apertus-open-source-cinema/alpha-hardware/SFE-PCB/ExpressPCB - discontinued/space-on-zedboard-01.jpg

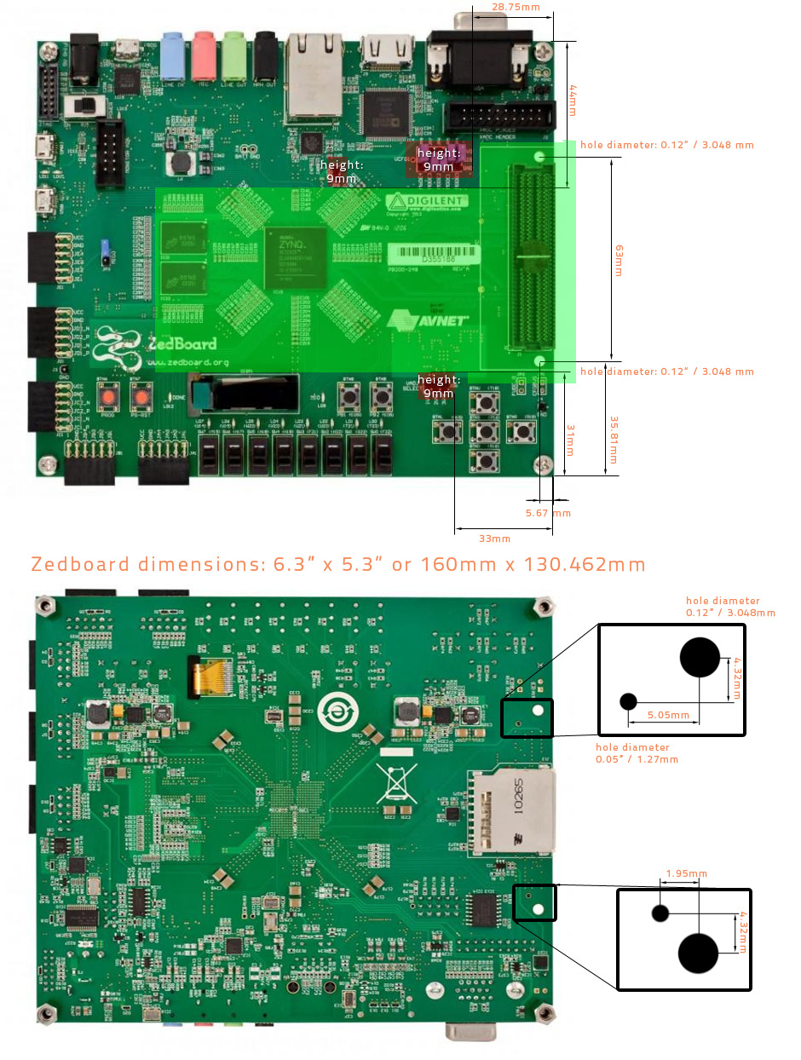
SFE-PCB/ExpressPCB - discontinued/space-on-zedboard-01.jpg
