apertus-open-source-cinema/alpha-hardware/README.md

alpha-hardware
==============

Axiom Alpha prototype hardware source files (electronic schematics, documentation, PCB layouts, etc.)
