apertus-open-source-cinema/alpha-hardware/Nikon-F-Mount/apertus-axiom-alpha-lens-mount01.jpg

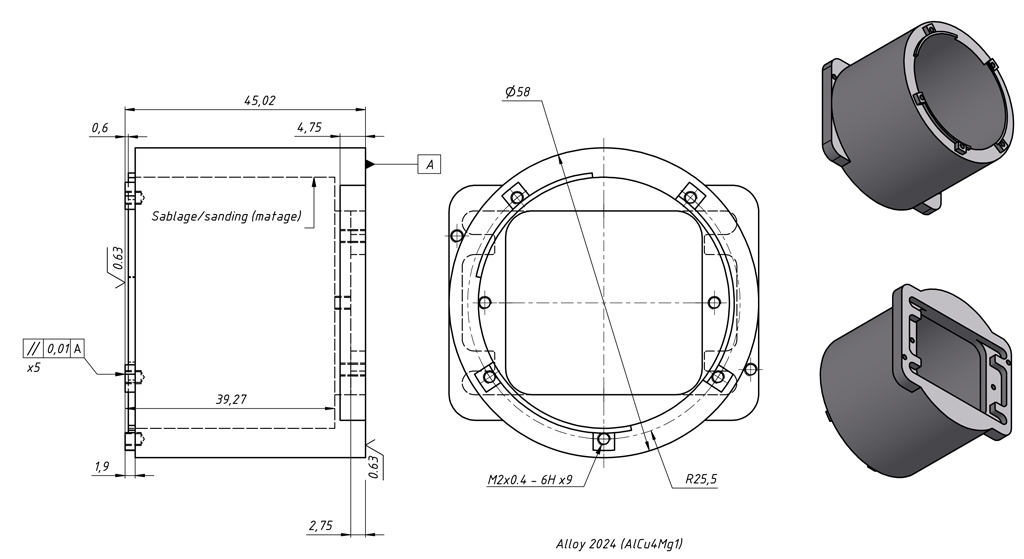
Nikon-F-Mount/apertus-axiom-alpha-lens-mount01.jpg
