apertus-open-source-cinema/alpha-hardware/Nikon-F-Mount/apertus-axiom-alpha-lens-mount03.jpg

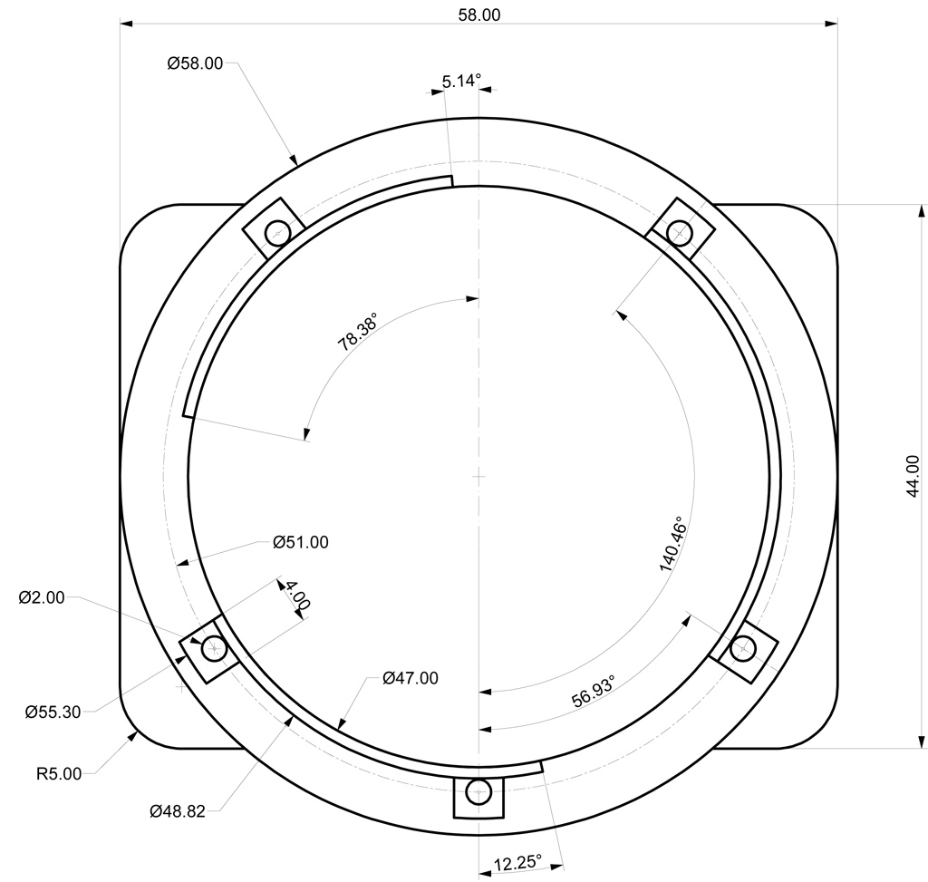
Nikon-F-Mount/apertus-axiom-alpha-lens-mount03.jpg
