apertus-open-source-cinema/alpha-hardware/Paddle/paddle_board.png

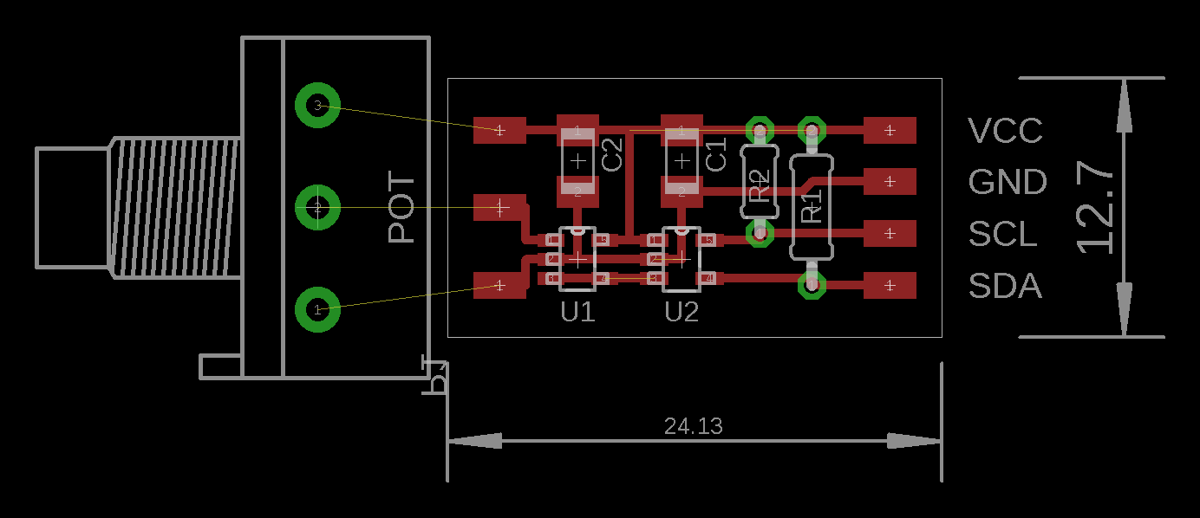
Paddle/paddle_board.png
