apertus-open-source-cinema/alpha-hardware/SFE-PCB/ExpressPCB - discontinued/power-planes01.jpg

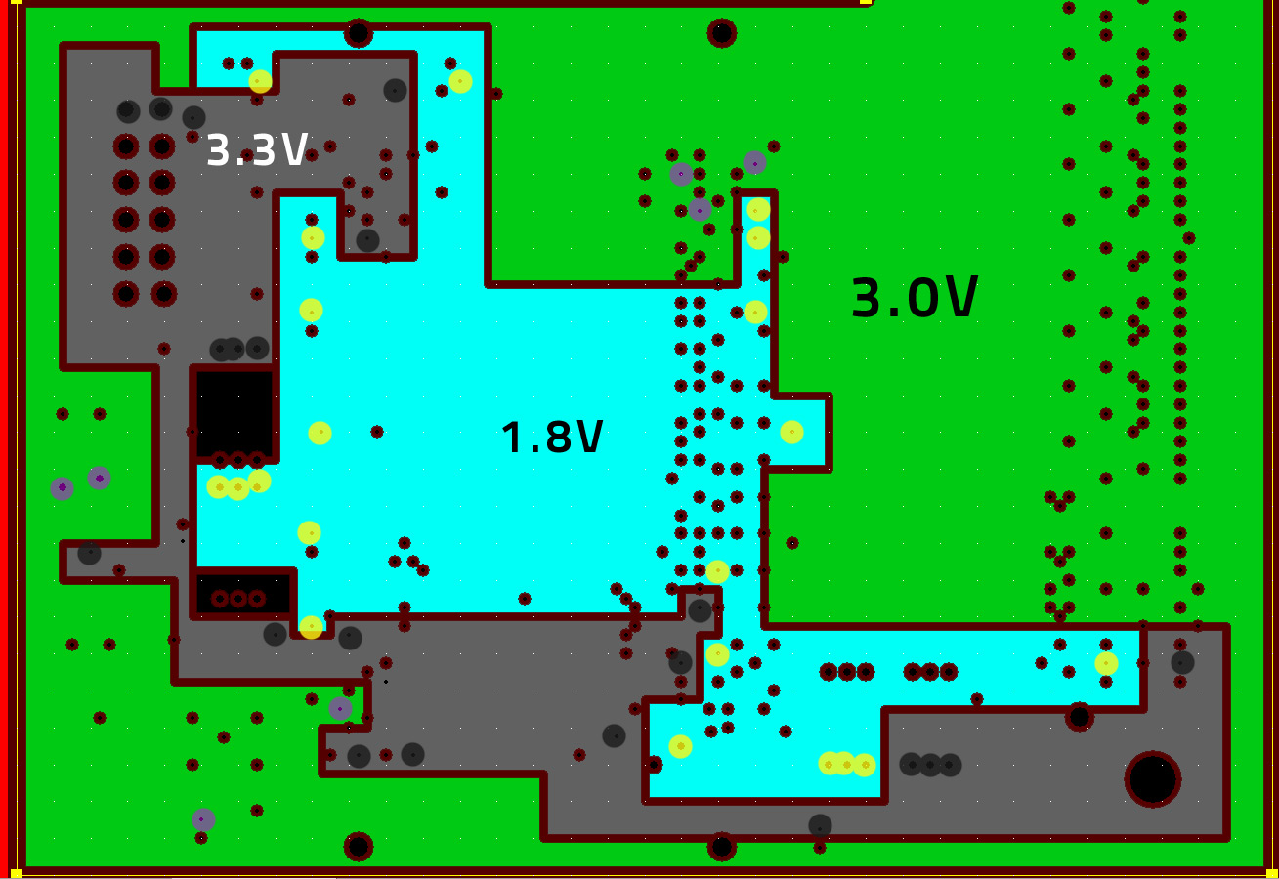
SFE-PCB/ExpressPCB - discontinued/power-planes01.jpg
