apertus-open-source-cinema/alpha-hardware/Nikon-F-Mount/F-mount to CMV12k-V04.stp

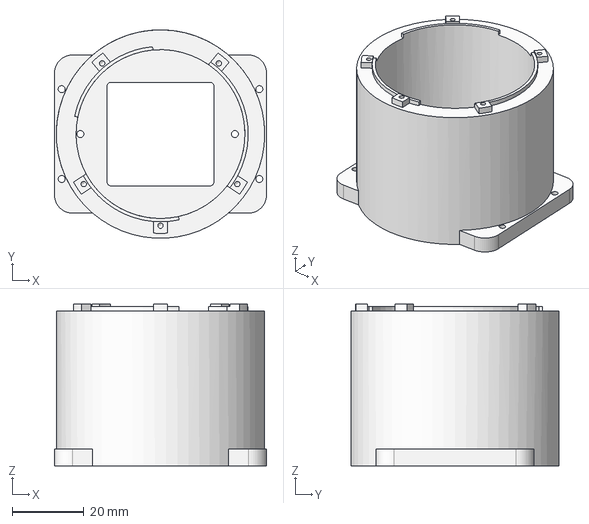
[picture p7: CAD file, 2014-06-10]
Nikon-F-Mount/F-mount to CMV12k-V04.stp
59.0 x 58.0 x 45.0 mm
