apertus-open-source-cinema/alpha-hardware/PMOD-Debug-LedMatrix/Readme.txt

About
---------
A very small PCB sporting 64 LEDs that connect to most FPGA development boards (like the Zedboard) with a PMOD interface
This PCB provides an easy way to debug FPGA logic with just 8 digital lines and a 4-to-16 line decoder with minimal interface logic required in the FPGA side (PL).

Filetypes
---------
Eagle Schematic and Board Design (XML)

License
---------
CERN Open Hardware License 1.1
http://www.ohwr.org/attachments/735/CERNOHLv1_1.txt

Author
---------
Herbert Poetzl - herbert@13thfloor.at
