apertus-open-source-cinema/alpha-hardware/Paddle/paddle_schematic.pdf

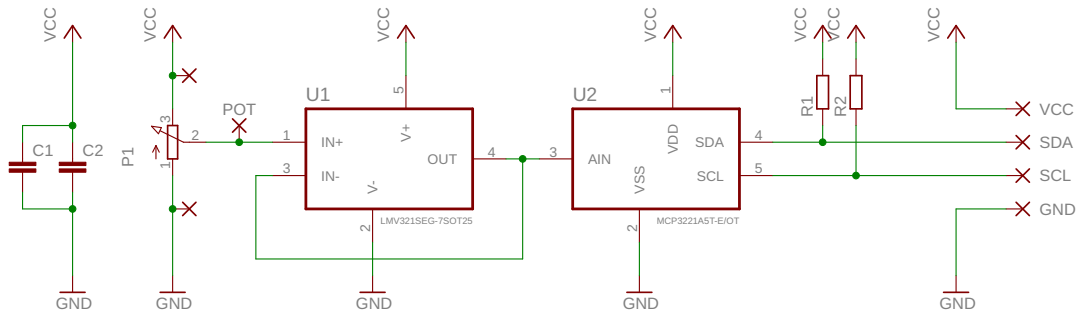
[picture p8: page 1]

Paddle Controller
Amplifier and IIC Digitizer
12bit Resolution, IIC Terminated
Copyright (C) 2014 H.Poetzl
Licensed under CERN OHL v.1.1
