apertus-open-source-cinema/alpha-hardware/Nikon-F-Mount/F-mount to CMV12k-V04.pdf

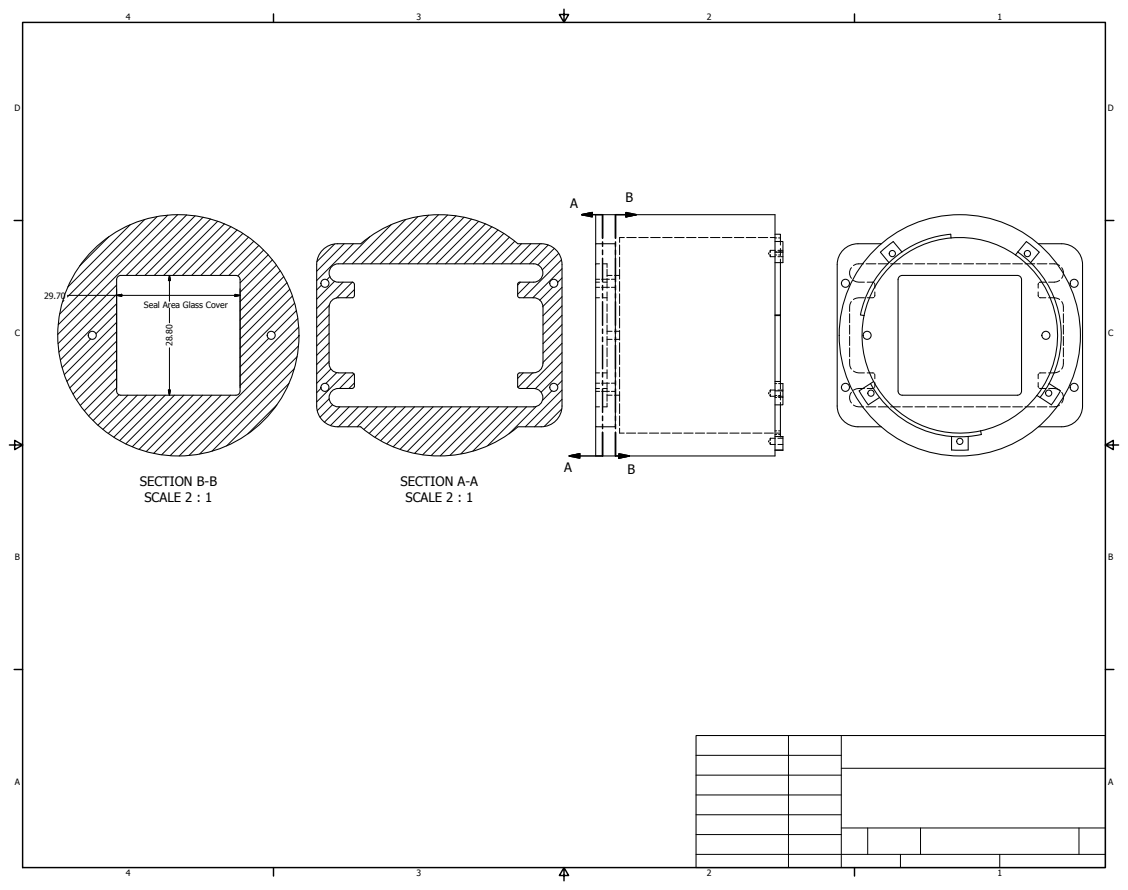
[picture p9: page 1]
SECTION A-A SCALE 2 : 1; SECTION B-B SCALE 2 : 1

Seal Area Glass Cover
