apertus-open-source-cinema/alpha-hardware/(list of files, drawings)

Other design files:
SFE-PCB/archived/ExpressPCB - discontinued/cmv12000 adapter V002.pcb
SFE-PCB/archived/ExpressPCB - discontinued/cmv12000 adapter V003.pcb
SFE-PCB/archived/ExpressPCB - discontinued/cmv12000 adapter V004.pcb
SFE-PCB/archived/ExpressPCB - discontinued/cmv12000 adapter V005.pcb
SFE-PCB/archived/ExpressPCB - discontinued/cmv12000 adapter V006.pcb
SFE-PCB/archived/ExpressPCB - discontinued/cmv12000 adapter V007.pcb
SFE-PCB/archived/ExpressPCB - discontinued/cmv12000 adapter V008.pcb
SFE-PCB/archived/ExpressPCB - discontinued/cmv12000 adapter V009.pcb
SFE-PCB/archived/ExpressPCB - discontinued/cmv12000 adapter.pcb
SFE-PCB/ExpressPCB - discontinued/cmv12000 adapter V002.pcb
SFE-PCB/ExpressPCB - discontinued/cmv12000 adapter V003.pcb
SFE-PCB/ExpressPCB - discontinued/cmv12000 adapter V004.pcb
SFE-PCB/ExpressPCB - discontinued/cmv12000 adapter V005.pcb
SFE-PCB/ExpressPCB - discontinued/cmv12000 adapter V006.pcb
SFE-PCB/ExpressPCB - discontinued/cmv12000 adapter V007.pcb
SFE-PCB/ExpressPCB - discontinued/cmv12000 adapter V008.pcb
SFE-PCB/ExpressPCB - discontinued/cmv12000 adapter V009.pcb
SFE-PCB/ExpressPCB - discontinued/cmv12000 adapter.pcb
