apertus-open-source-cinema/alpha-hardware/Paddle/paddle.brd

## EAGLE design Paddle/paddle.brd (2014-04-01)

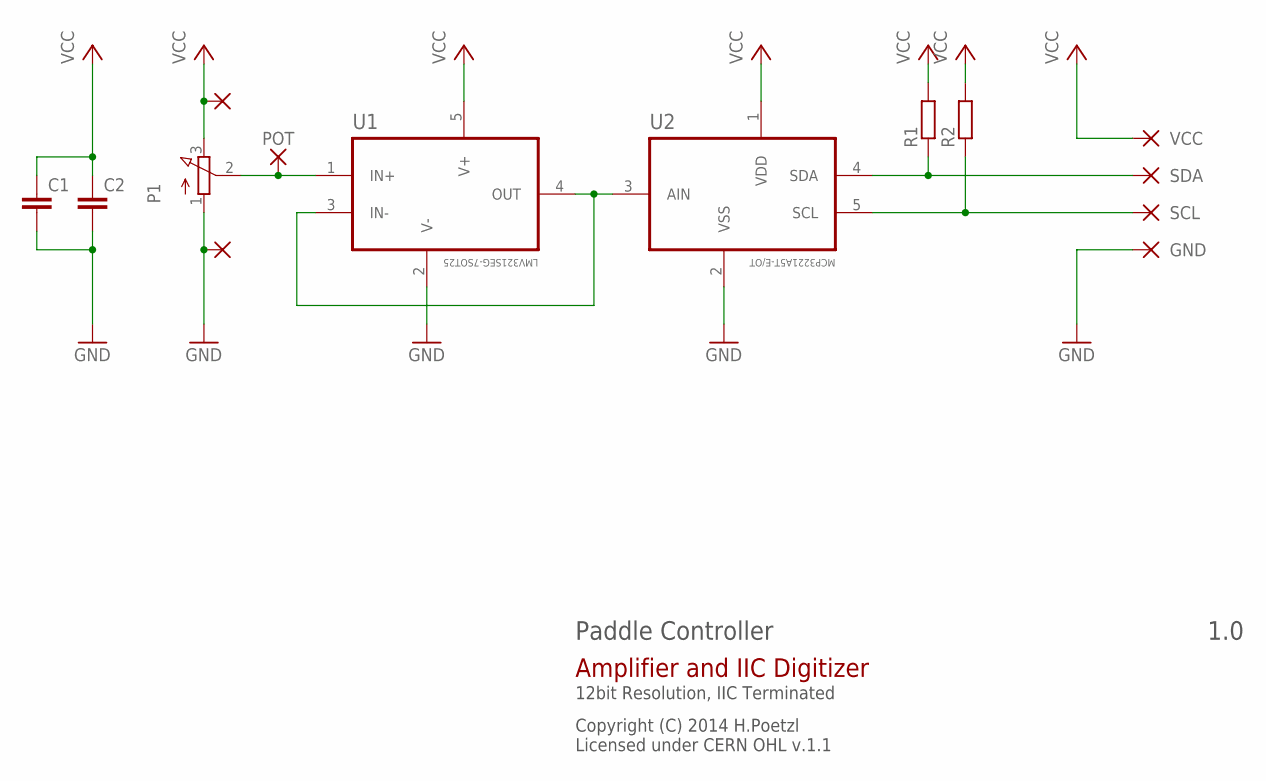
[picture p10: schematic paddle.sch]

Parts:
C1, C2: C-EUC1206K; C1206K
GND: SMD2; SMD1,27-2,54
P1: 3RP/1610N
POT: SMD2; SMD1,27-2,54
R1: R-EU_0204/7; 0204/7
R2: R-EU_0204/5; 0204/5
SCL: SMD2; SMD1,27-2,54
SDA: SMD2; SMD1,27-2,54
U1: LMV321SEG-7SOT25; SOT95P280X145-5N
U2: MCP3221A5T-E/OT; SOT95P270X145-5N
VCC, VCC1, VCC2: SMD2; SMD1,27-2,54

Connections:
GND: C1.2, C2.2, GND.1, P1.1 (A), U1.2 (V-), U2.2 (VSS), VCC2.1
unnamed: U1.3 (IN-), U1.4 (OUT), U2.3 (AIN)
POT: P1.2 (S), POT.1, U1.1 (IN+)
SCL: R2.1, SCL.1, U2.5 (SCL)
SDA: R1.1, SDA.1, U2.4 (SDA)
VCC: C1.1, C2.1, P1.3 (E), R1.2, R2.2, U1.5 (V+), U2.1 (VDD), VCC.1, VCC1.1

Notes on the sheet:
Paddle Controller
Copyright (C) 2014 H.Poetzl Licensed under CERN OHL v.1.1
Amplifier and IIC Digitizer
12bit Resolution, IIC Terminated

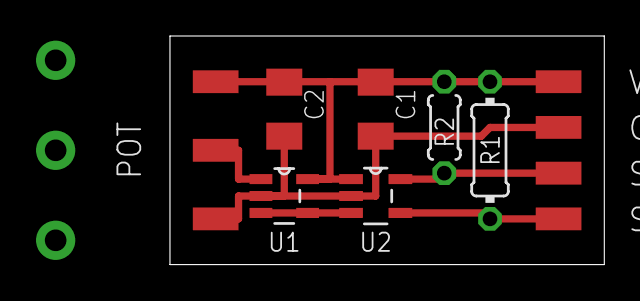
[picture p11: board paddle.brd from above]

Board: 2 copper layers, 24.1 x 12.7 mm, 14 parts (1 on the bottom side), 6 nets.
