apertus-open-source-cinema/alpha-hardware/SFE-PCB/cmv12k-adapter-v1.1/cmv12k-adapter-v1.1.brd

## EAGLE design SFE-PCB/cmv12k-adapter-v1.1/cmv12k-adapter-v1.1.brd (2013-10-28, an earlier design)

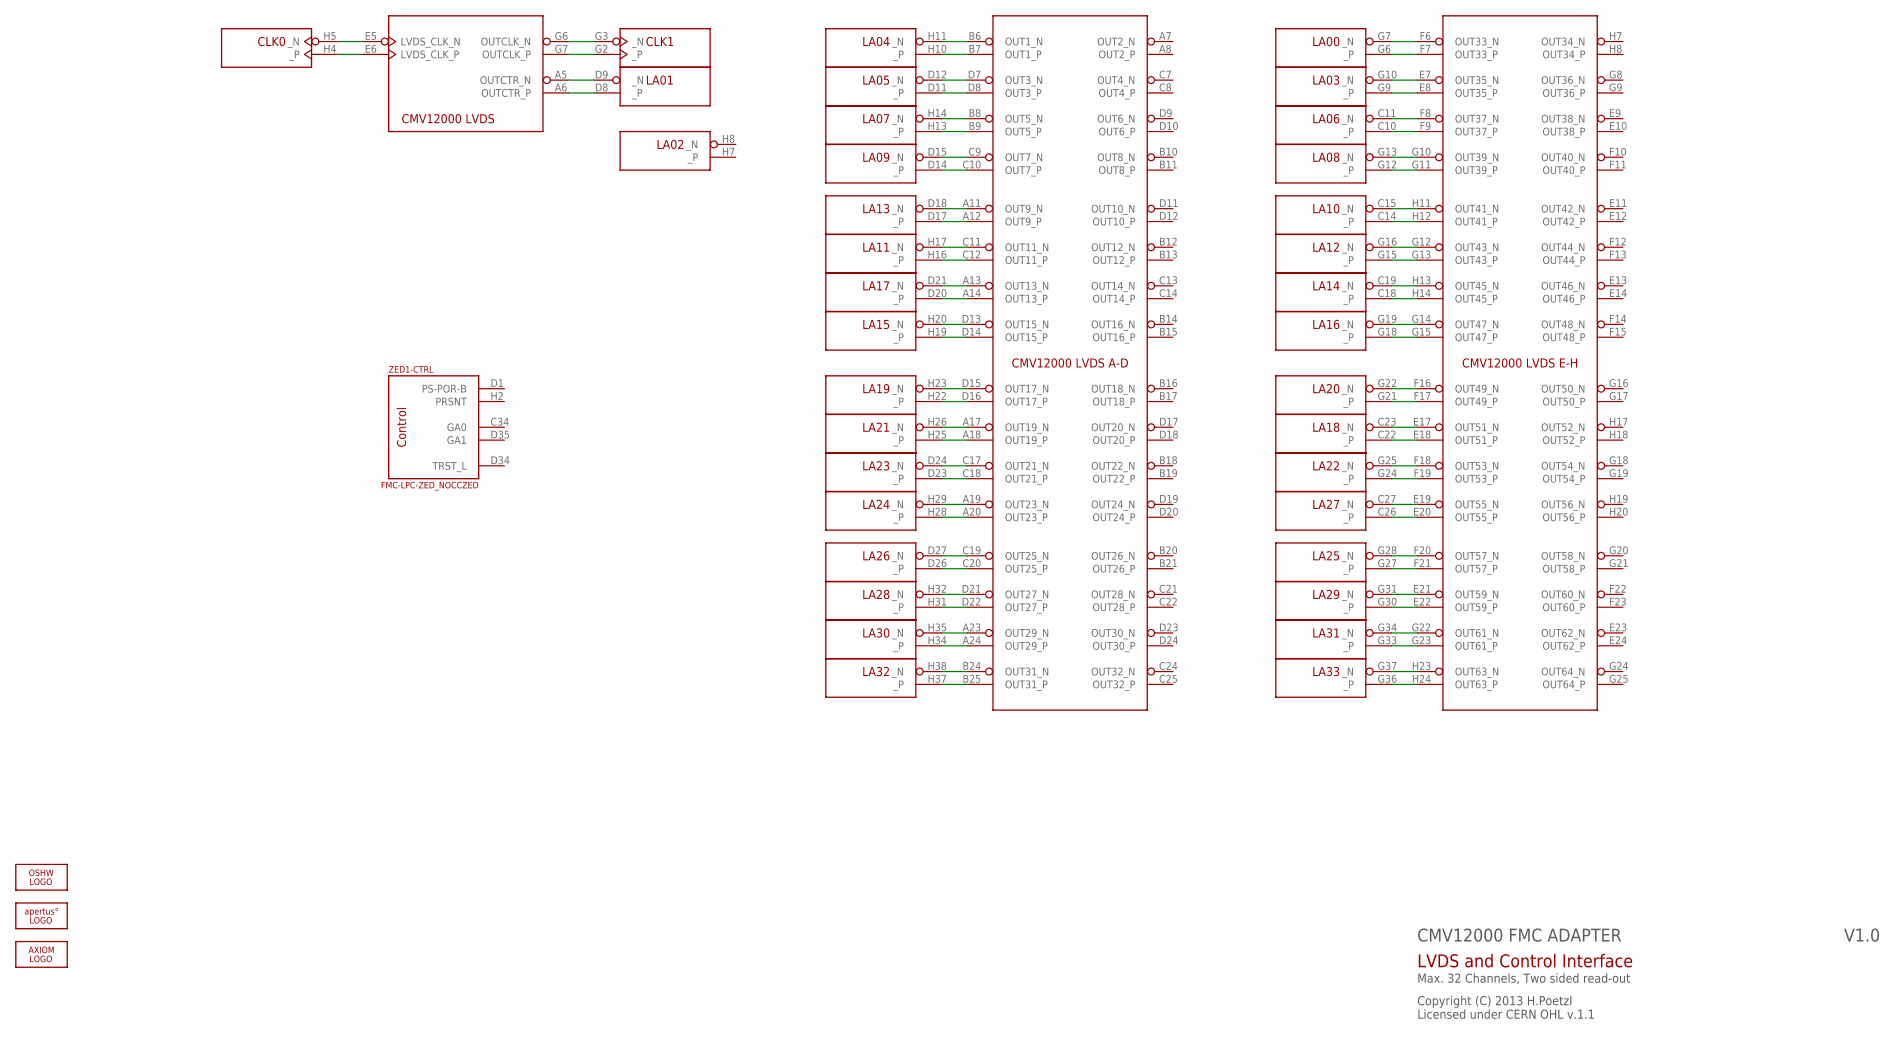
[picture p12: schematic cmv12k-adapter-v1.1.sch, sheet 1]

Parts:
LOGO1: OSHW_LOGO_FILLX0100-NT; OSHW_FILLX100_NOTEXT
U$1: CMV12000ANDON+LM; 10-30-07-237-400T4+LM
U$5: APERTUS_LOGO334X100; APERTUS_LOGO_334X100
U$13: AXIOM_LOGO525X80; AXIOM_LOGO_525X80
ZED1: FMC-LPC-ZED_NOCCZED; ASP-134604-01-ZED

Connections:
unnamed: U$1.B6 (OUT1_N), ZED1.H11 (_N)
unnamed: U$1.B7 (OUT1_P), ZED1.H10 (_P)
unnamed: U$1.D7 (OUT3_N), ZED1.D12 (_N)
unnamed: U$1.D8 (OUT3_P), ZED1.D11 (_P)
unnamed: U$1.B8 (OUT5_N), ZED1.H14 (_N)
unnamed: U$1.C9 (OUT7_N), ZED1.D15 (_N)
unnamed: U$1.C10 (OUT7_P), ZED1.D14 (_P)
unnamed: U$1.G10 (OUT39_N), ZED1.G13 (_N)
unnamed: U$1.A11 (OUT9_N), ZED1.D18 (_N)
unnamed: U$1.A12 (OUT9_P), ZED1.D17 (_P)
unnamed: U$1.C11 (OUT11_N), ZED1.H17 (_N)
unnamed: U$1.C12 (OUT11_P), ZED1.H16 (_P)
unnamed: U$1.A13 (OUT13_N), ZED1.D21 (_N)
unnamed: U$1.A14 (OUT13_P), ZED1.D20 (_P)
unnamed: U$1.D13 (OUT15_N), ZED1.H20 (_N)
unnamed: U$1.D14 (OUT15_P), ZED1.H19 (_P)
unnamed: U$1.F16 (OUT49_N), ZED1.G22 (_N)
unnamed: U$1.F17 (OUT49_P), ZED1.G21 (_P)
unnamed: U$1.A17 (OUT19_N), ZED1.H26 (_N)
unnamed: U$1.A18 (OUT19_P), ZED1.H25 (_P)
unnamed: U$1.C17 (OUT21_N), ZED1.D24 (_N)
unnamed: U$1.C18 (OUT21_P), ZED1.D23 (_P)
unnamed: U$1.A19 (OUT23_N), ZED1.H29 (_N)
unnamed: U$1.A20 (OUT23_P), ZED1.H28 (_P)
unnamed: U$1.C19 (OUT25_N), ZED1.D27 (_N)
unnamed: U$1.C20 (OUT25_P), ZED1.D26 (_P)
unnamed: U$1.D21 (OUT27_N), ZED1.H32 (_N)
unnamed: U$1.D22 (OUT27_P), ZED1.H31 (_P)
unnamed: U$1.A23 (OUT29_N), ZED1.H35 (_N)
unnamed: U$1.A24 (OUT29_P), ZED1.H34 (_P)
unnamed: U$1.B24 (OUT31_N), ZED1.H38 (_N)
unnamed: U$1.B25 (OUT31_P), ZED1.H37 (_P)
unnamed: U$1.D15 (OUT17_N), ZED1.H23 (_N)
unnamed: U$1.D16 (OUT17_P), ZED1.H22 (_P)
unnamed: U$1.G22 (OUT61_N), ZED1.G34 (_N)
unnamed: U$1.G23 (OUT61_P), ZED1.G33 (_P)
unnamed: U$1.E22 (OUT59_P), ZED1.G30 (_P)
unnamed: U$1.E21 (OUT59_N), ZED1.G31 (_N)
unnamed: U$1.F21 (OUT57_P), ZED1.G27 (_P)
unnamed: U$1.F20 (OUT57_N), ZED1.G28 (_N)
unnamed: U$1.E20 (OUT55_P), ZED1.C26 (_P)
unnamed: U$1.E19 (OUT55_N), ZED1.C27 (_N)
unnamed: U$1.F19 (OUT53_P), ZED1.G24 (_P)
unnamed: U$1.F18 (OUT53_N), ZED1.G25 (_N)
unnamed: U$1.E18 (OUT51_P), ZED1.C22 (_P)
unnamed: U$1.E17 (OUT51_N), ZED1.C23 (_N)
unnamed: U$1.H23 (OUT63_N), ZED1.G37 (_N)
unnamed: U$1.H24 (OUT63_P), ZED1.G36 (_P)
unnamed: U$1.G15 (OUT47_P), ZED1.G18 (_P)
unnamed: U$1.G14 (OUT47_N), ZED1.G19 (_N)
unnamed: U$1.H14 (OUT45_P), ZED1.C18 (_P)
unnamed: U$1.H13 (OUT45_N), ZED1.C19 (_N)
unnamed: U$1.G13 (OUT43_P), ZED1.G15 (_P)
unnamed: U$1.G12 (OUT43_N), ZED1.G16 (_N)
unnamed: U$1.H12 (OUT41_P), ZED1.C14 (_P)
unnamed: U$1.H11 (OUT41_N), ZED1.C15 (_N)
unnamed: U$1.G11 (OUT39_P), ZED1.G12 (_P)
unnamed: U$1.B9 (OUT5_P), ZED1.H13 (_P)
unnamed: U$1.F9 (OUT37_P), ZED1.C10 (_P)
unnamed: U$1.F8 (OUT37_N), ZED1.C11 (_N)
unnamed: U$1.E8 (OUT35_P), ZED1.G9 (_P)
unnamed: U$1.E7 (OUT35_N), ZED1.G10 (_N)
unnamed: U$1.F7 (OUT33_P), ZED1.G6 (_P)
unnamed: U$1.F6 (OUT33_N), ZED1.G7 (_N)
unnamed: U$1.E5 (LVDS_CLK_N), ZED1.H5 (_N)
unnamed: U$1.E6 (LVDS_CLK_P), ZED1.H4 (_P)
unnamed: U$1.G6 (OUTCLK_N), ZED1.G3 (_N)
unnamed: U$1.G7 (OUTCLK_P), ZED1.G2 (_P)
unnamed: U$1.A5 (OUTCTR_N), ZED1.D9 (_N)
unnamed: U$1.A6 (OUTCTR_P), ZED1.D8 (_P)

Notes on the sheet:
CMV12000 FMC ADAPTER
Copyright (C) 2013 H.Poetzl Licensed under CERN OHL v.1.1
LVDS and Control Interface
Max. 32 Channels, Two sided read-out

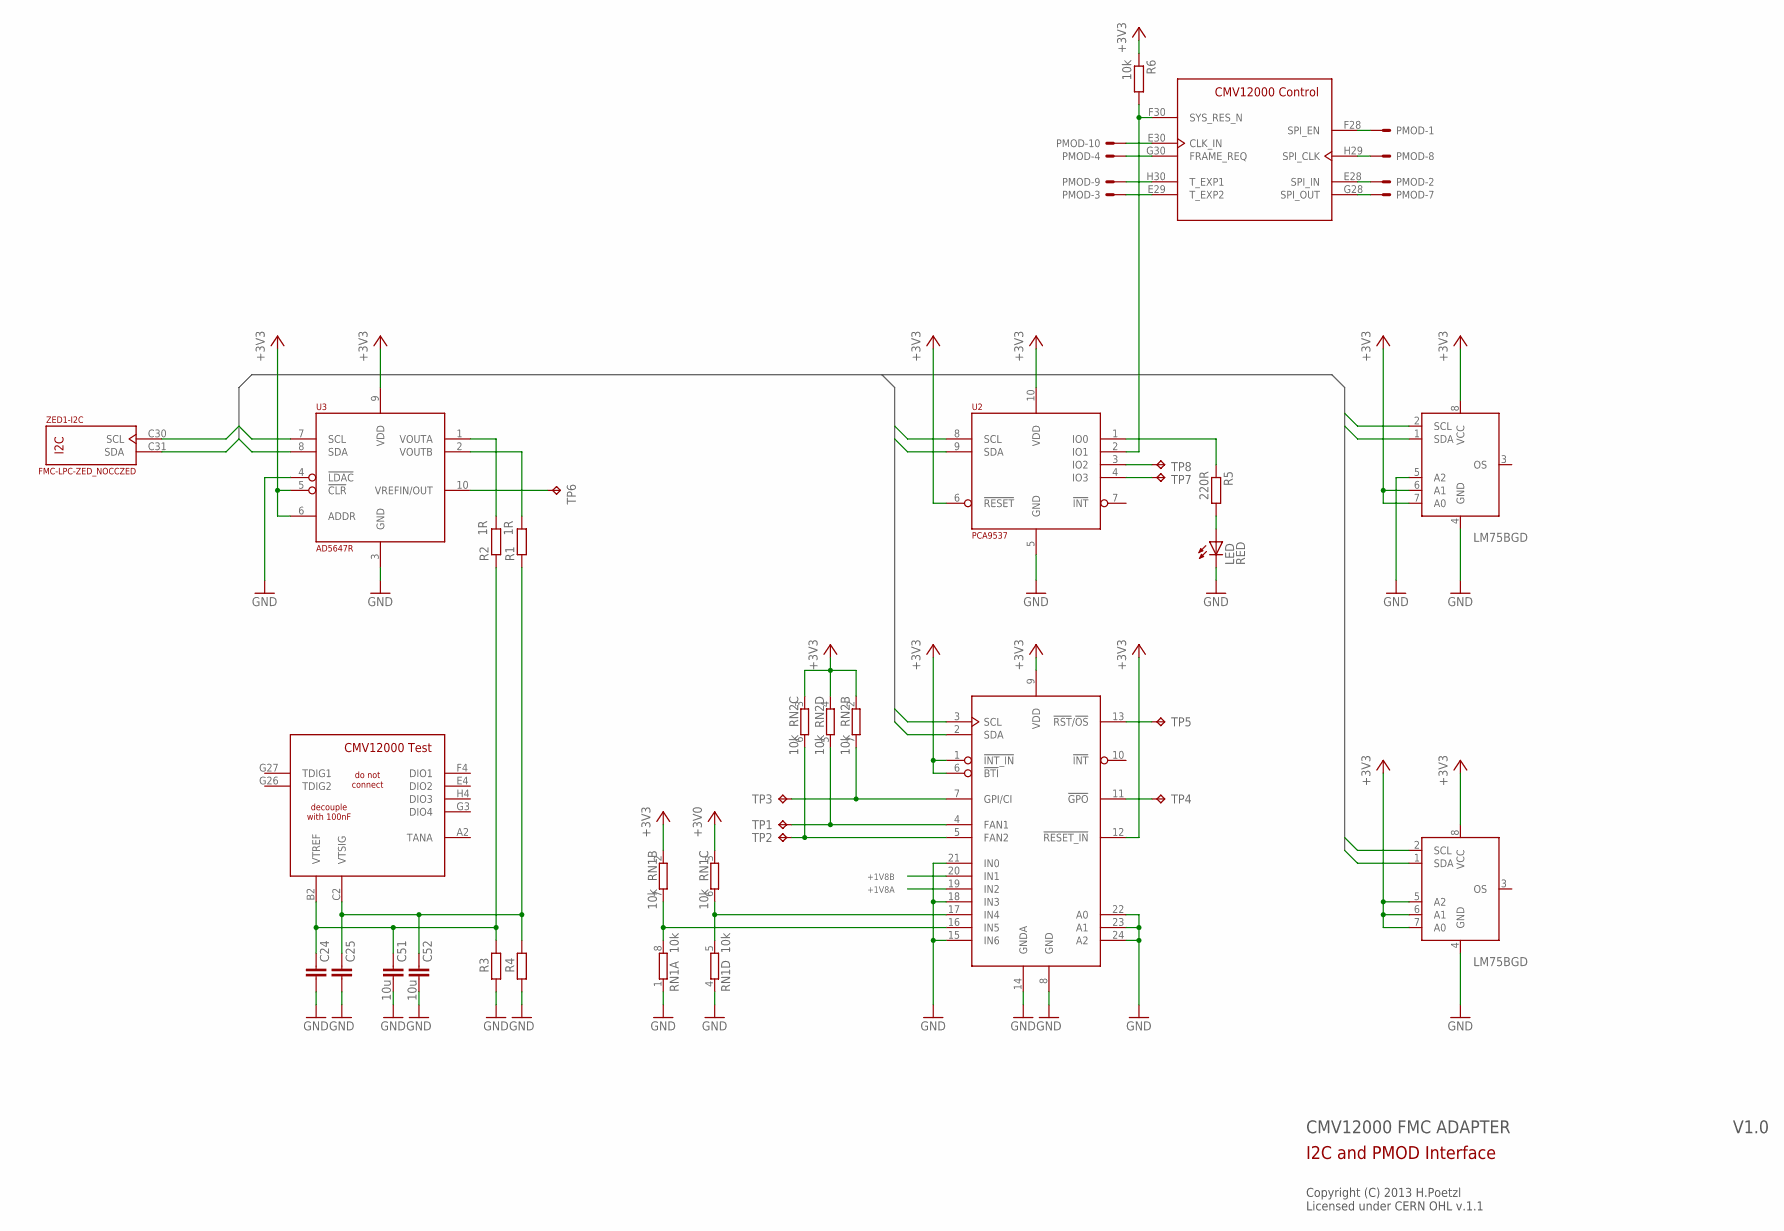
[picture p13: schematic cmv12k-adapter-v1.1.sch, sheet 2]

Parts:
C24, C25: 100n; C0402
C51, C52: 10u; C0603K
LED: RED; CHIP-LED0603
PMOD: PMOD-8; 2X04/90/2MM
R1, R2: 1R; R0402
R3, R4: R-EU_R0402; R0402
R5: 220R; R0402
R6: 10k; R0402
RN1, RN2: 10k; EXBV8V
TP1, TP2, TP3, TP4, TP5, TP6, TP7, TP8: TPB1,27; B1,27
U1: LM96080; TSSOP24
U2: PCA9537; TSSOP-10
U3: AD5647R; SOP50P490X110-10N
U4, U5: LM75BGD; SOT996-2/3
U$1: CMV12000ANDON+LM; 10-30-07-237-400T4+LM
ZED1: FMC-LPC-ZED_NOCCZED; ASP-134604-01-ZED

Connections:
+1V8A: U1.19 (IN2); also elsewhere on the board
+1V8B: U1.20 (IN1); also elsewhere on the board
+3V0: RN1.3 (1); also elsewhere on the board
+3V3: R6.1, RN1.2 (1), RN2.2 (1), RN2.3 (1), RN2.4 (1), U1.1 (!INT_IN), U1.6 (!BTI), U1.9 (VDD), U1.12 (!RESET_IN), U2.6 (!RESET), U2.10 (VDD), U3.5 (!CLR), U3.6 (ADDR), U3.9 (VDD), U4.6 (A1), U4.7 (A0), U4.8 (VCC), U5.5 (A2), U5.6 (A1), U5.7 (A0), U5.8 (VCC); also elsewhere on the board
GND: C24.2, C25.2, C51.2, C52.2, LED.C, R3.2, R4.2, RN1.1, RN1.4 (1), U1.8 (GND), U1.14 (GNDA), U1.15 (IN6), U1.18 (IN3), U1.21 (IN0), U1.22 (A0), U1.23 (A1), U1.24 (A2), U2.5 (GND), U3.3 (GND), U3.4 (!LDAC), U4.4 (GND), U4.5 (A2), U5.4 (GND); also elsewhere on the board
unnamed: PMOD.1, U$1.F28 (SPI_EN)
unnamed: PMOD.8, U$1.H29 (SPI_CLK)
unnamed: PMOD.2, U$1.E28 (SPI_IN)
unnamed: PMOD.7, U$1.G28 (SPI_OUT)
unnamed: PMOD.10, U$1.E30 (CLK_IN)
unnamed: PMOD.4, U$1.G30 (FRAME_REQ)
unnamed: R1.2, U3.2 (VOUTB)
unnamed: PMOD.9, U$1.H30 (T_EXP1)
unnamed: PMOD.3, U$1.E29 (T_EXP2)
unnamed: RN2.5 (2), TP1.TP, U1.4 (FAN1)
unnamed: R6.2, U2.2 (IO1), U$1.F30 (SYS_RES_N)
unnamed: R5.1, U2.1 (IO0)
unnamed: RN2.6 (2), TP2.TP, U1.5 (FAN2)
unnamed: TP8.TP, U2.3 (IO2)
unnamed: TP7.TP, U2.4 (IO3)
unnamed: RN1.5 (2), RN1.6 (2), U1.17 (IN4)
unnamed: RN2.7 (2), TP3.TP, U1.7 (GPI/CI)
unnamed: TP4.TP, U1.11 (!GPO)
unnamed: TP5.TP, U1.13 (!RST!/!OS!)
unnamed: RN1.7 (2), RN1.8 (2), U1.16 (IN5)
unnamed: R2.2, U3.1 (VOUTA)
unnamed: LED.A, R5.2
unnamed: TP6.TP, U3.10 (VREFIN/OUT)
SCL: U1.3 (SCL), U2.8 (SCL), U3.7 (SCL), U4.2 (SCL), U5.2 (SCL), ZED1.C30 (SCL)
SDA: U1.2 (SDA), U2.9 (SDA), U3.8 (SDA), U4.1 (SDA), U5.1 (SDA), ZED1.C31 (SDA)
VTREF: C24.1, C51.1, R2.1, R3.1, U$1.B2 (VTREF)
VTSIG: C25.1, C52.1, R1.1, R4.1, U$1.C2 (VTSIG)

Notes on the sheet:
CMV12000 FMC ADAPTER
Copyright (C) 2013 H.Poetzl Licensed under CERN OHL v.1.1
I2C and PMOD Interface

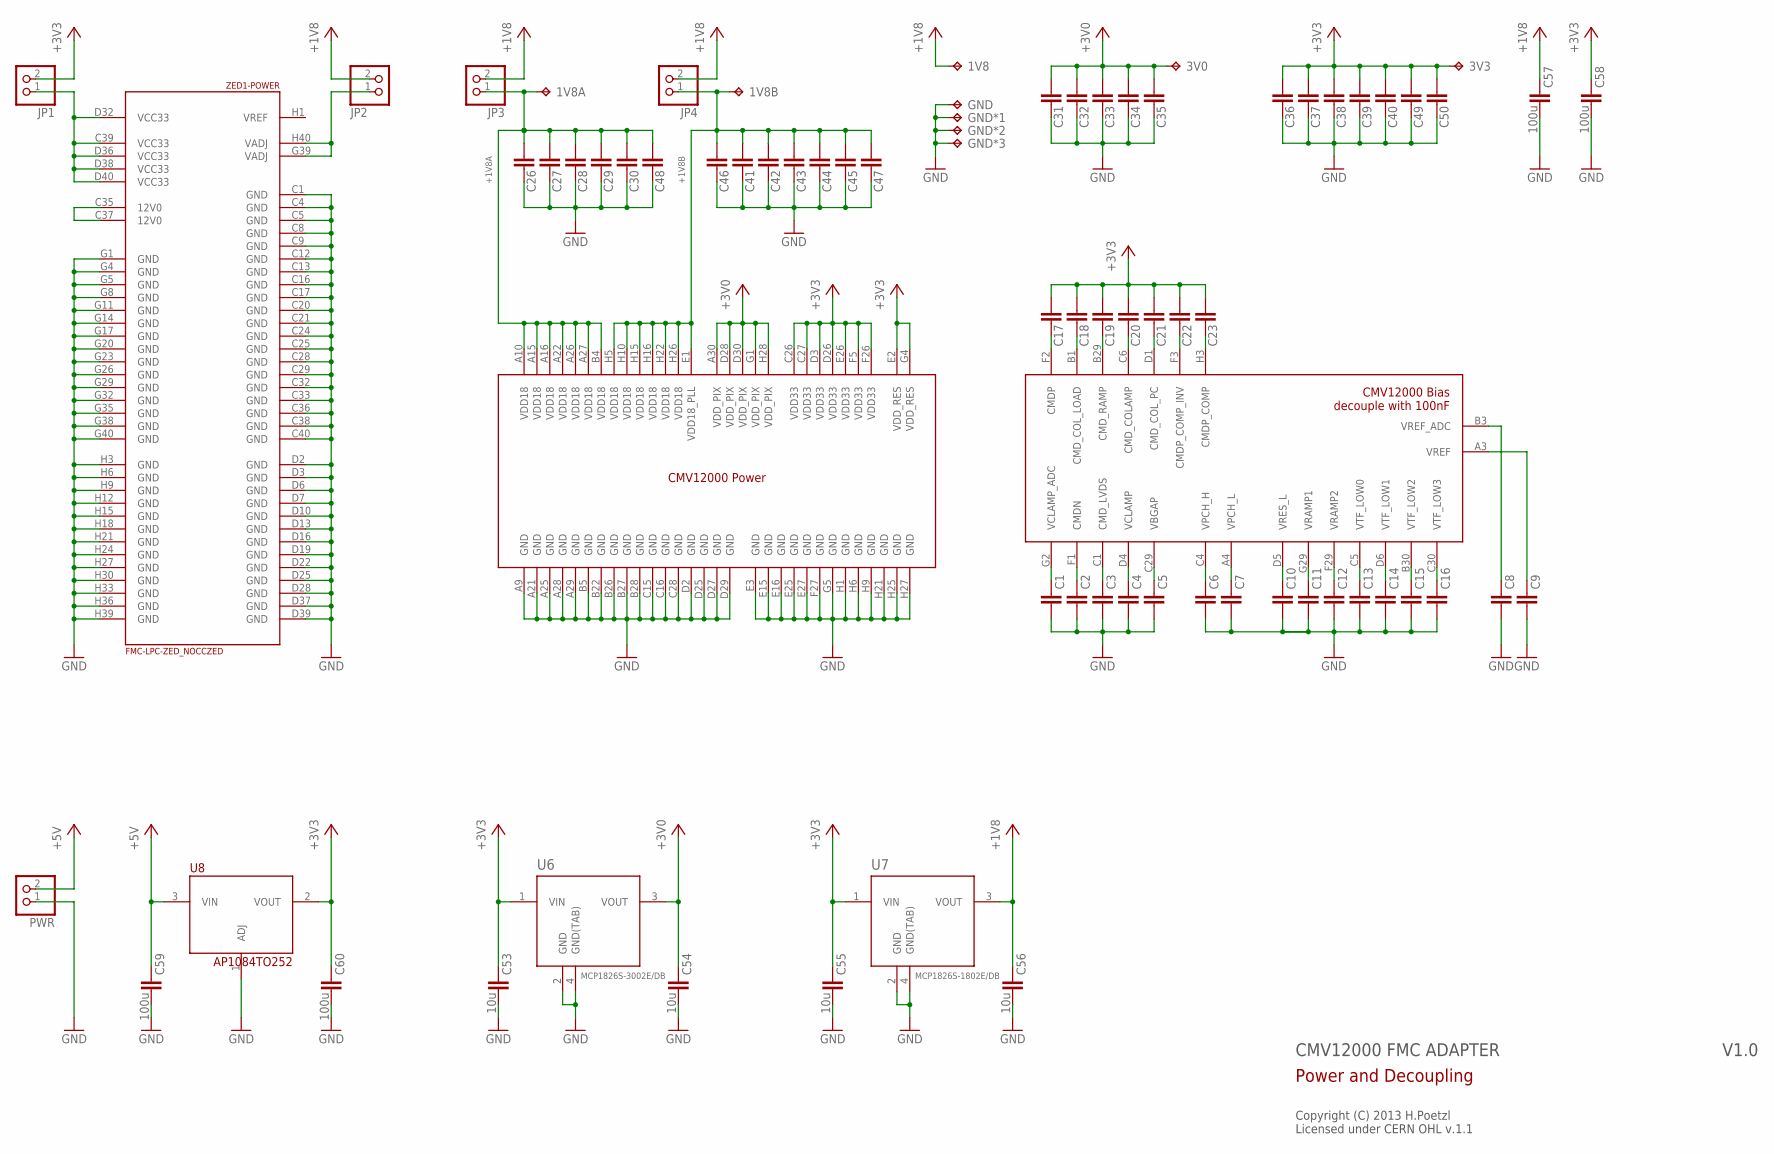
[picture p14: schematic cmv12k-adapter-v1.1.sch, sheet 3]

Parts:
1V8, 1V8A, 1V8B, 3V0, 3V3: TPB1,27; B1,27
C1, C2, C3, C4, C5, C6, C7, C8, C9, C10, C11, C12, C13, C14, C15, C16, C17, C18, C19, C20, C21, C22, C23, C26, C27, C28, C29, C30, C31, C32, C33, C34, C35, C36, C37, C38, C39, C40, C41, C42, C43, C44, C45, C46, C47, C48, C49, C50: 100n; C0402
C53, C54, C55, C56: 10u; C0603K
C57, C58: 100u; C1210
C59, C60: 100u; C1210K
GND: TPB1,27; B1,27
GND*1, GND*2, GND*3: TPB1,27; B1,27
JP1, JP2, JP3, JP4: PINHD-1X02_2.54-S; 1X02-S
PWR: PINHD-1X02_2.54-S; 1X02-S
U6: MCP1826S-3002E/DB; SOT230P700X180-4N
U7: MCP1826S-1802E/DB; SOT230P700X180-4N
U8: AP1084TO252; TO252
U$1: CMV12000ANDON+LM; 10-30-07-237-400T4+LM
ZED1: FMC-LPC-ZED_NOCCZED; ASP-134604-01-ZED

Connections:
+1V8: 1V8.TP, C56.1, C57.1, JP2.2, JP3.2, JP4.2, U7.3 (VOUT)
+1V8A: 1V8A.TP, C26.1, C27.1, C28.1, C29.1, C30.1, C48.1, JP3.1, U$1.A10 (VDD18), U$1.A15 (VDD18), U$1.A16 (VDD18), U$1.A22 (VDD18), U$1.A26 (VDD18), U$1.A27 (VDD18), U$1.B4 (VDD18); also elsewhere on the board
+1V8B: 1V8B.TP, C41.1, C42.1, C43.1, C44.1, C45.1, C46.1, C47.1, JP4.1, U$1.E1 (VDD18_PLL), U$1.H5 (VDD18), U$1.H10 (VDD18), U$1.H15 (VDD18), U$1.H16 (VDD18), U$1.H22 (VDD18), U$1.H26 (VDD18); also elsewhere on the board
+3V0: 3V0.TP, C31.1, C32.1, C33.1, C34.1, C35.1, C54.1, U6.3 (VOUT), U$1.A30 (VDD_PIX), U$1.D28 (VDD_PIX), U$1.D30 (VDD_PIX), U$1.G1 (VDD_PIX), U$1.H28 (VDD_PIX); also elsewhere on the board
+3V3: 3V3.TP, C17.1, C18.1, C19.1, C20.1, C21.1, C22.1, C23.1, C36.1, C37.1, C38.1, C39.1, C40.1, C49.1, C50.1, C53.1, C55.1, C58.1, C60.1, JP1.2, U6.1 (VIN), U7.1 (VIN), U8.2 (VOUT), U$1.C26 (VDD33), U$1.C27 (VDD33), U$1.D3 (VDD33), U$1.D26 (VDD33), U$1.E2 (VDD_RES), U$1.E26 (VDD33), U$1.F5 (VDD33), U$1.F26 (VDD33), U$1.G4 (VDD_RES); also elsewhere on the board
+5V: C59.1, PWR.2, U8.3 (VIN)
GND: C1.2, C2.2, C3.2, C4.2, C5.2, C6.2, C7.2, C8.2, C9.2, C10.2, C11.2, C12.2, C13.2, C14.2, C15.2, C16.2, C26.2, C27.2, C28.2, C29.2, C30.2, C31.2, C32.2, C33.2, C34.2, C35.2, C36.2, C37.2, C38.2, C39.2, C40.2, C41.2, C42.2, C43.2, C44.2, C45.2, C46.2, C47.2, C48.2, C49.2, C50.2, C53.2, C54.2, C55.2, C56.2, C57.2, C58.2, C59.2, C60.2, GND.TP, GND*1.TP, GND*2.TP, GND*3.TP, PWR.1, U6.2 (GND), U6.4 (GND(TAB)), U7.2 (GND), U7.4 (GND(TAB)), U8.1 (ADJ), U$1.A9 (GND), U$1.A21 (GND), U$1.A25 (GND), U$1.A28 (GND), U$1.A29 (GND), U$1.B5 (GND), U$1.B22 (GND), U$1.B26 (GND), U$1.B27 (GND), U$1.B28 (GND), U$1.C15 (GND), U$1.C16 (GND), U$1.C28 (GND), U$1.D2 (GND), U$1.D25 (GND), U$1.D27 (GND), U$1.D29 (GND), U$1.E3 (GND), U$1.E15 (GND), U$1.E16 (GND), U$1.E25 (GND), U$1.E27 (GND), U$1.F27 (GND), U$1.G5 (GND), U$1.H1 (GND), U$1.H6 (GND), U$1.H9 (GND), U$1.H21 (GND), U$1.H25 (GND), U$1.H27 (GND), ZED1.C1 (GND), ZED1.C4 (GND), ZED1.C5 (GND), ZED1.C8 (GND), ZED1.C9 (GND), ZED1.C12 (GND), ZED1.C13 (GND), ZED1.C16 (GND), ZED1.C17 (GND), ZED1.C20 (GND), ZED1.C21 (GND), ZED1.C24 (GND), ZED1.C25 (GND), ZED1.C28 (GND), ZED1.C29 (GND), ZED1.C32 (GND), ZED1.C33 (GND), ZED1.C36 (GND), ZED1.C38 (GND), ZED1.C40 (GND), ZED1.D2 (GND), ZED1.D3 (GND), ZED1.D6 (GND), ZED1.D7 (GND), ZED1.D10 (GND), ZED1.D13 (GND), ZED1.D16 (GND), ZED1.D19 (GND), ZED1.D22 (GND), ZED1.D25 (GND), ZED1.D28 (GND), ZED1.D37 (GND), ZED1.D39 (GND), ZED1.G1 (GND), ZED1.G4 (GND), ZED1.G5 (GND), ZED1.G8 (GND), ZED1.G11 (GND), ZED1.G14 (GND), ZED1.G17 (GND), ZED1.G20 (GND), ZED1.G23 (GND), ZED1.G26 (GND), ZED1.G29 (GND), ZED1.G32 (GND), ZED1.G35 (GND), ZED1.G38 (GND), ZED1.G40 (GND), ZED1.H3 (GND), ZED1.H6 (GND), ZED1.H9 (GND), ZED1.H12 (GND), ZED1.H15 (GND), ZED1.H18 (GND), ZED1.H21 (GND), ZED1.H24 (GND), ZED1.H27 (GND), ZED1.H30 (GND), ZED1.H33 (GND), ZED1.H36 (GND), ZED1.H39 (GND); also elsewhere on the board
unnamed: C17.2, U$1.F2 (CMDP)
unnamed: C18.2, U$1.B1 (CMD_COL_LOAD)
unnamed: C19.2, U$1.B29 (CMD_RAMP)
unnamed: C20.2, U$1.C6 (CMD_COLAMP)
unnamed: C21.2, U$1.D1 (CMD_COL_PC)
unnamed: C22.2, U$1.F3 (CMDP_COMP_INV)
unnamed: C23.2, U$1.H3 (CMDP_COMP)
unnamed: C1.1, U$1.G2 (VCLAMP_ADC)
unnamed: C2.1, U$1.F1 (CMDN)
unnamed: C3.1, U$1.C1 (CMD_LVDS)
unnamed: C4.1, U$1.D4 (VCLAMP)
unnamed: C5.1, U$1.C29 (VBGAP)
unnamed: C6.1, U$1.C4 (VPCH_H)
unnamed: C7.1, U$1.A4 (VPCH_L)
unnamed: C8.1, U$1.B3 (VREF_ADC)
unnamed: C9.1, U$1.A3 (VREF)
unnamed: C10.1, U$1.D5 (VRES_L)
unnamed: C11.1, U$1.G29 (VRAMP1)
unnamed: C12.1, U$1.F29 (VRAMP2)
unnamed: C13.1, U$1.C5 (VTF_LOW0)
unnamed: C14.1, U$1.D6 (VTF_LOW1)
unnamed: C15.1, U$1.B30 (VTF_LOW2)
unnamed: C16.1, U$1.C30 (VTF_LOW3)
unnamed: ZED1.C35 (12V0), ZED1.C37 (12V0)
unnamed: JP1.1, ZED1.C39 (VCC33), ZED1.D32 (VCC33), ZED1.D36 (VCC33), ZED1.D38 (VCC33), ZED1.D40 (VCC33)
unnamed: JP2.1, ZED1.G39 (VADJ), ZED1.H40 (VADJ)

Notes on the sheet:
CMV12000 FMC ADAPTER
Copyright (C) 2013 H.Poetzl Licensed under CERN OHL v.1.1
Power and Decoupling

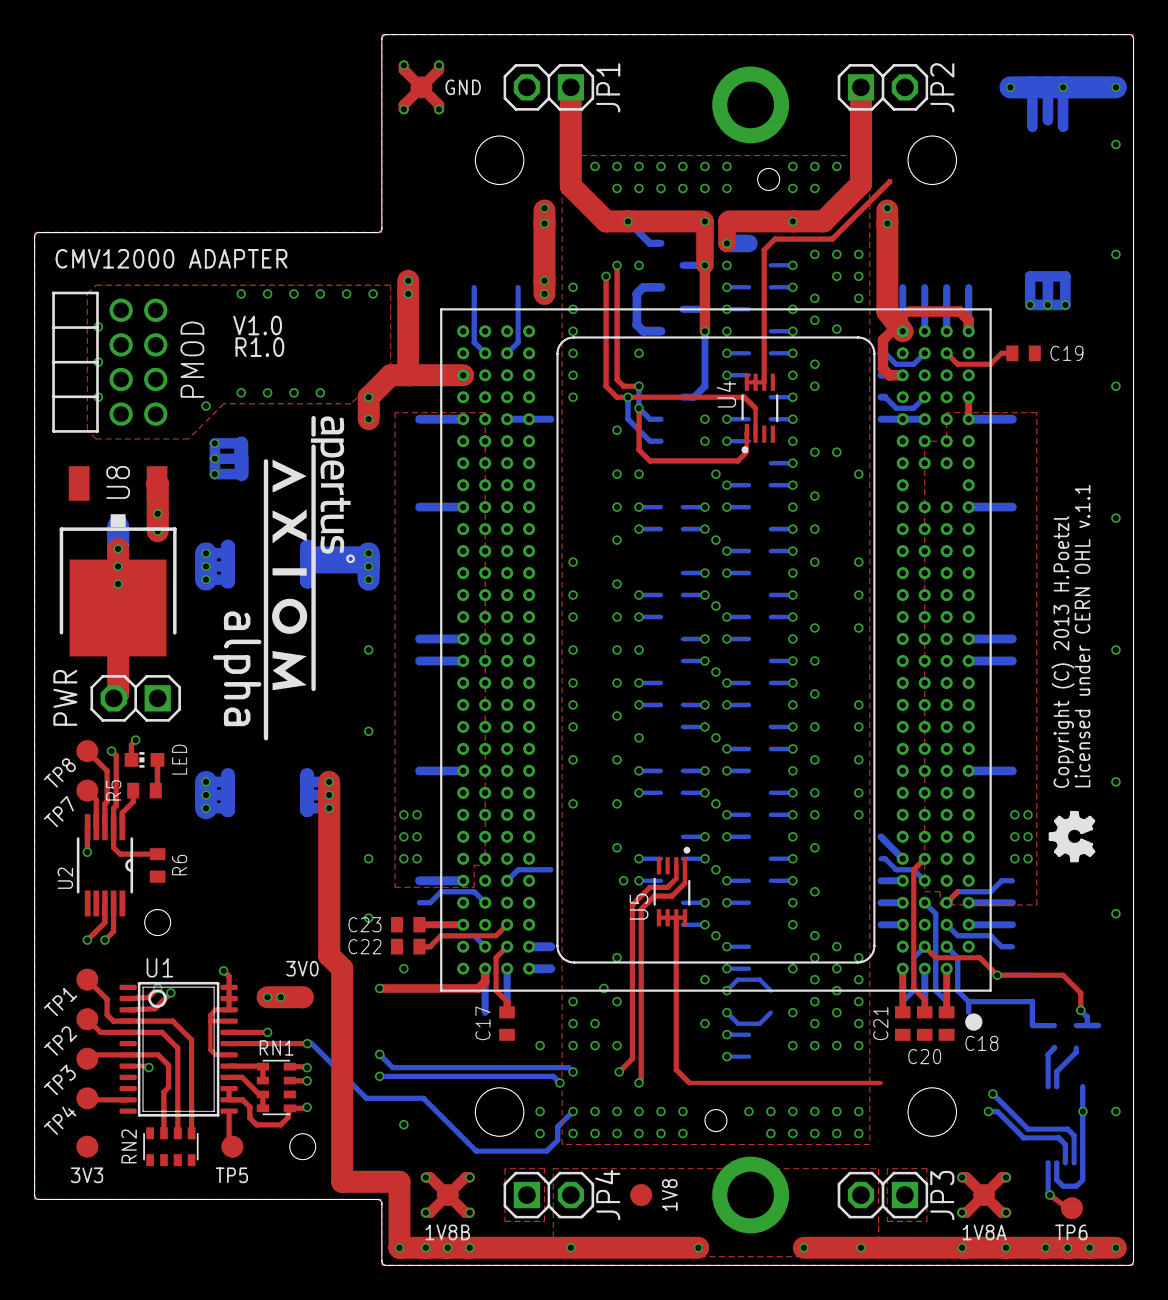
[picture p15: board cmv12k-adapter-v1.1.brd from above]

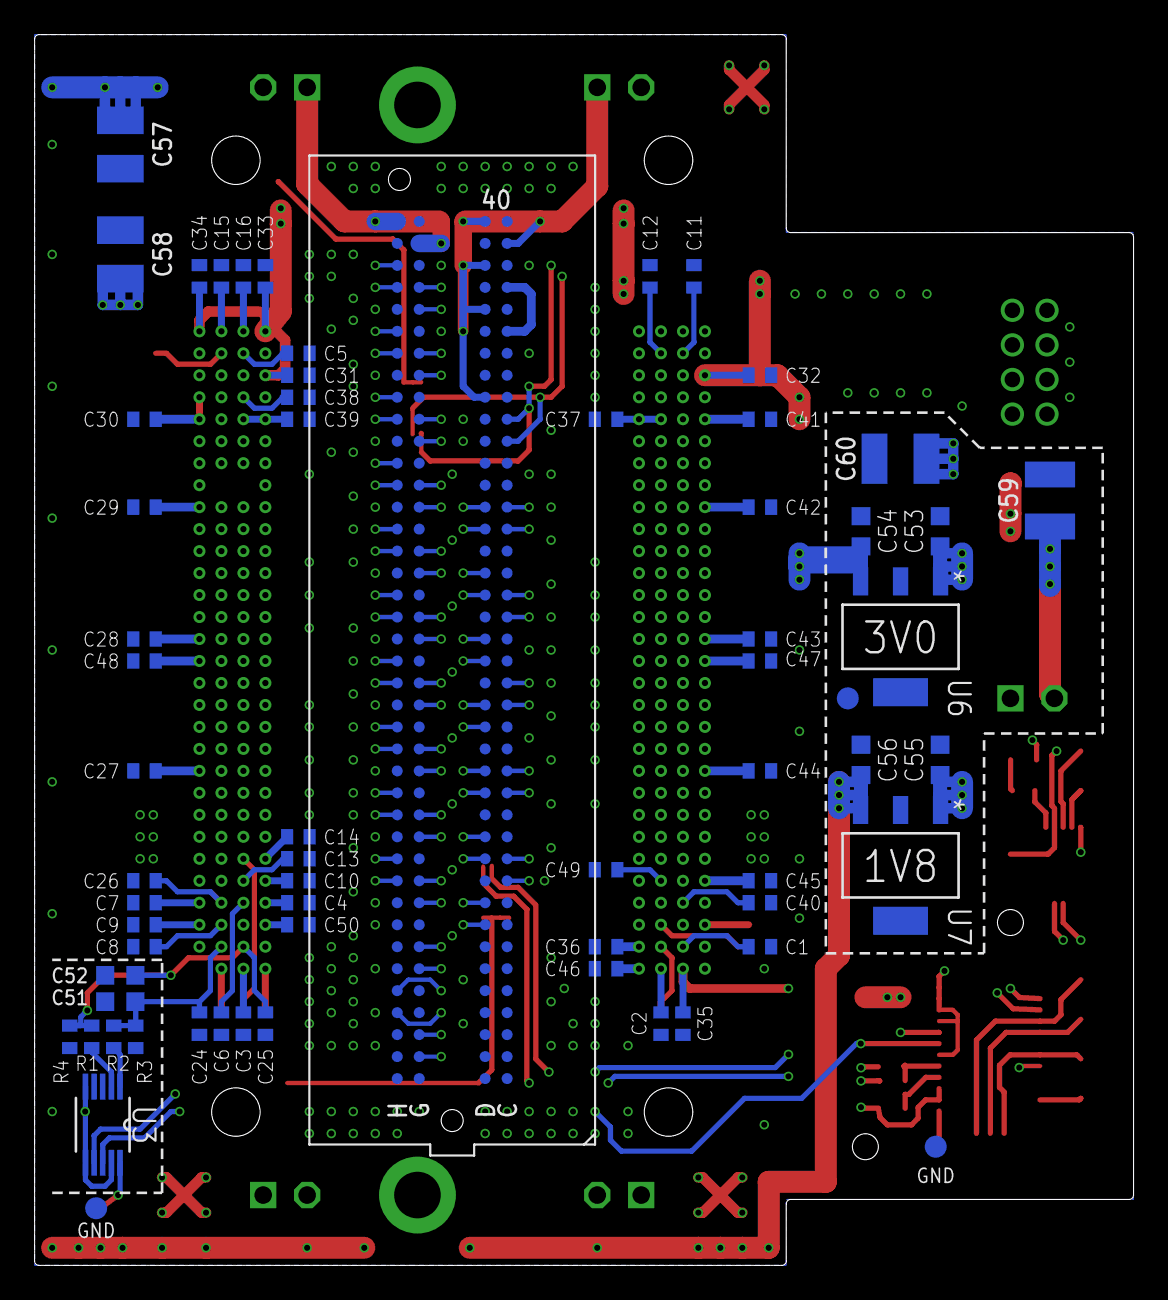
[picture p16: board cmv12k-adapter-v1.1.brd from below]

Board: 4 copper layers, 63.5 x 71.1 mm, 105 parts (63 on the bottom side), 130 nets.
