apertus-open-source-cinema/alpha-hardware/PMOD-Debug-LedMatrix/pmod_debug.brd

## EAGLE design PMOD-Debug-LedMatrix/pmod_debug.brd (2013-07-08)

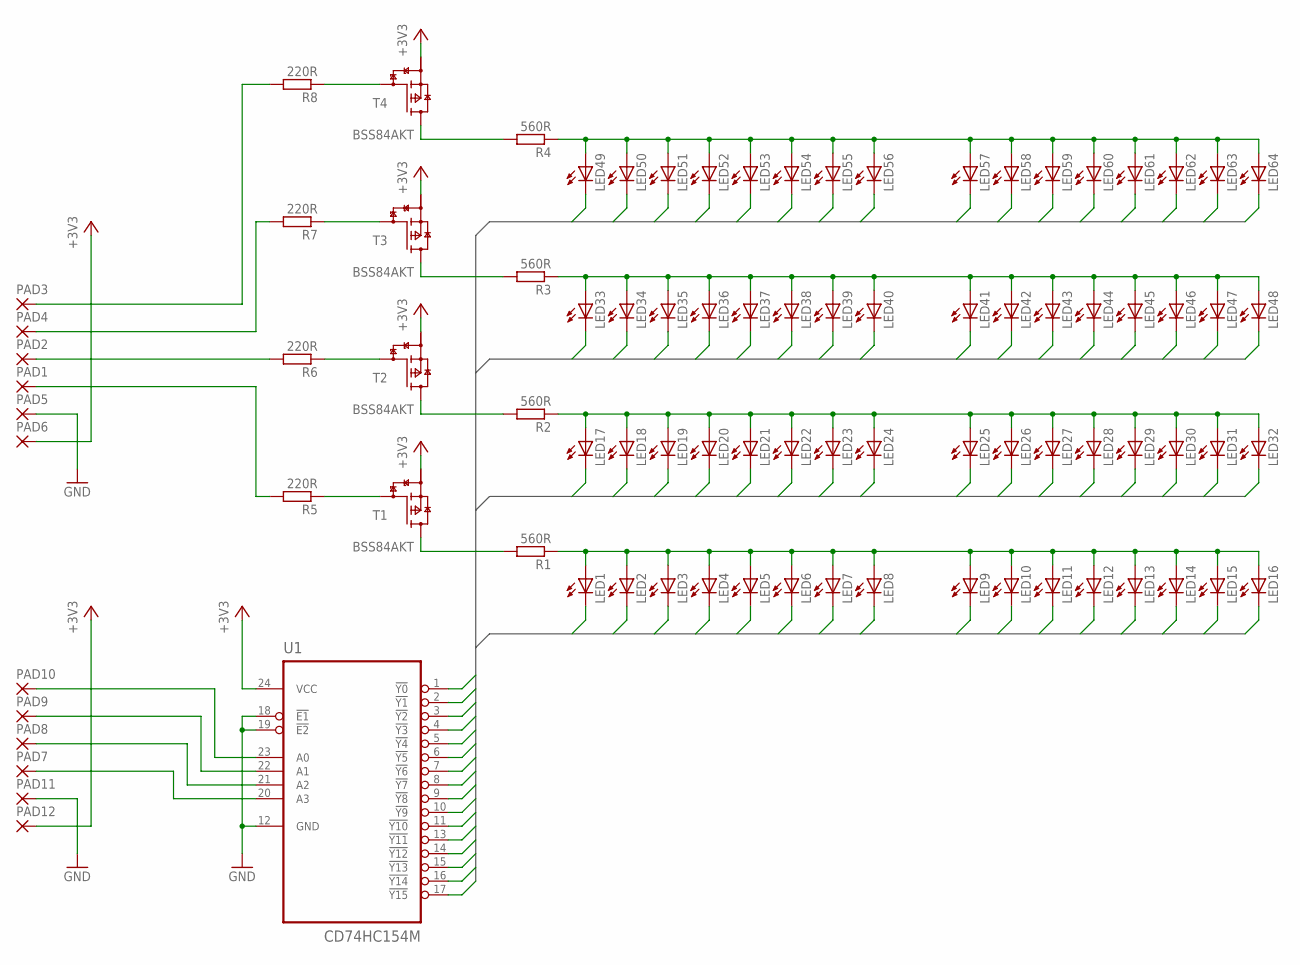
[picture p17: schematic pmod_debug.sch]

Parts:
LED1, LED2, LED3, LED4, LED5, LED6, LED7, LED8, LED9, LED10, LED11, LED12, LED13, LED14, LED15, LED16, LED17, LED18, LED19, LED20, LED21, LED22, LED23, LED24, LED25, LED26, LED27, LED28, LED29, LED30, LED31, LED32, LED33, LED34, LED35, LED36, LED37, LED38, LED39, LED40, LED41, LED42, LED43, LED44, LED45, LED46, LED47, LED48, LED49, LED50, LED51, LED52, LED53, LED54, LED55, LED56, LED57, LED58, LED59, LED60, LED61, LED62, LED63, LED64: LEDCHIP-LED0603; CHIP-LED0603
PAD1, PAD2, PAD3, PAD4, PAD5, PAD6, PAD7, PAD8, PAD9, PAD10, PAD11, PAD12: SMD2HR; SMD1.27-3.175HR
R1, R2, R3, R4: 560R; R0402
R5, R6, R7, R8: 220R; R0402
T1, T2, T3, T4: BSS84AKT; SOT416
U1: CD74HC154M; SOIC127P1030X265-24N

Connections:
+3V3: PAD6.1, PAD12.1, T1.2 (S), T2.2 (S), T3.2 (S), T4.2 (S), U1.24 (VCC)
C0: LED1.C, LED17.C, LED33.C, LED49.C, U1.1 (!Y0)
C1: LED2.C, LED18.C, LED34.C, LED50.C, U1.2 (!Y1)
C2: LED3.C, LED19.C, LED35.C, LED51.C, U1.3 (!Y2)
C3: LED4.C, LED20.C, LED36.C, LED52.C, U1.4 (!Y3)
C4: LED5.C, LED21.C, LED37.C, LED53.C, U1.5 (!Y4)
C5: LED6.C, LED22.C, LED38.C, LED54.C, U1.6 (!Y5)
C6: LED7.C, LED23.C, LED39.C, LED55.C, U1.7 (!Y6)
C7: LED8.C, LED24.C, LED40.C, LED56.C, U1.8 (!Y7)
C8: LED9.C, LED25.C, LED41.C, LED57.C, U1.9 (!Y8)
C9: LED10.C, LED26.C, LED42.C, LED58.C, U1.10 (!Y9)
C10: LED11.C, LED27.C, LED43.C, LED59.C, U1.11 (!Y10)
C11: LED12.C, LED28.C, LED44.C, LED60.C, U1.13 (!Y11)
C12: LED13.C, LED29.C, LED45.C, LED61.C, U1.14 (!Y12)
C13: LED14.C, LED30.C, LED46.C, LED62.C, U1.15 (!Y13)
C14: LED15.C, LED31.C, LED47.C, LED63.C, U1.16 (!Y14)
C15: LED16.C, LED32.C, LED48.C, LED64.C, U1.17 (!Y15)
GND: PAD5.1, PAD11.1, U1.12 (GND), U1.18 (!E1), U1.19 (!E2)
unnamed: LED1.A, LED2.A, LED3.A, LED4.A, LED5.A, LED6.A, LED7.A, LED8.A, LED9.A, LED10.A, LED11.A, LED12.A, LED13.A, LED14.A, LED15.A, LED16.A, R1.1
unnamed: LED17.A, LED18.A, LED19.A, LED20.A, LED21.A, LED22.A, LED23.A, LED24.A, LED25.A, LED26.A, LED27.A, LED28.A, LED29.A, LED30.A, LED31.A, LED32.A, R2.1
unnamed: LED33.A, LED34.A, LED35.A, LED36.A, LED37.A, LED38.A, LED39.A, LED40.A, LED41.A, LED42.A, LED43.A, LED44.A, LED45.A, LED46.A, LED47.A, LED48.A, R3.1
unnamed: LED49.A, LED50.A, LED51.A, LED52.A, LED53.A, LED54.A, LED55.A, LED56.A, LED57.A, LED58.A, LED59.A, LED60.A, LED61.A, LED62.A, LED63.A, LED64.A, R4.1
unnamed: R4.2, T4.3 (D)
unnamed: R3.2, T3.3 (D)
unnamed: R1.2, T1.3 (D)
unnamed: R2.2, T2.3 (D)
unnamed: R8.1, T4.1 (G)
unnamed: R7.1, T3.1 (G)
unnamed: R5.1, T1.1 (G)
unnamed: R6.1, T2.1 (G)
unnamed: PAD10.1, U1.23 (A0)
unnamed: PAD9.1, U1.22 (A1)
unnamed: PAD8.1, U1.21 (A2)
unnamed: PAD7.1, U1.20 (A3)
unnamed: PAD1.1, R5.2
unnamed: PAD2.1, R6.2
unnamed: PAD3.1, R8.2
unnamed: PAD4.1, R7.2

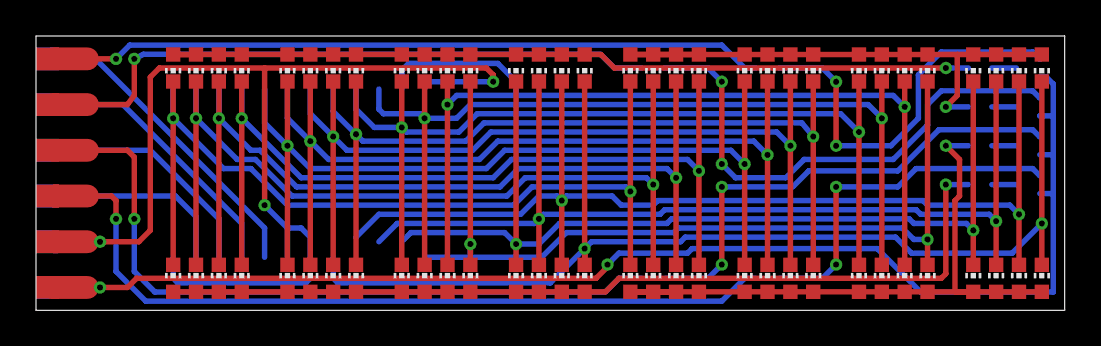
[picture p18: board pmod_debug.brd from above]

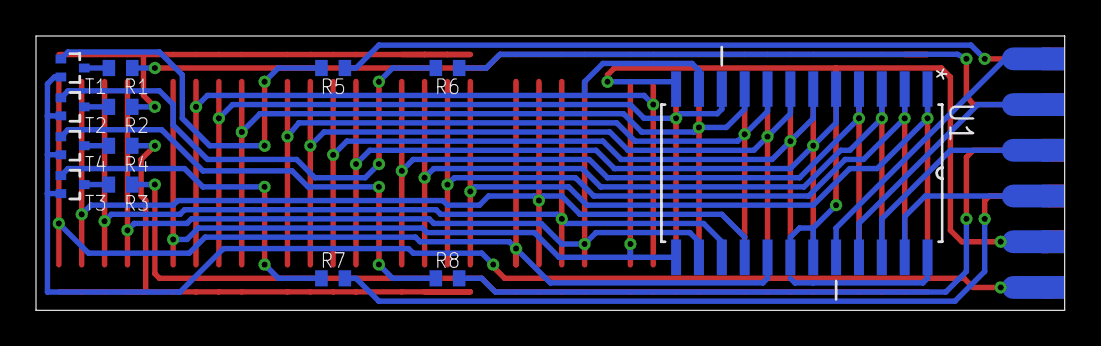
[picture p19: board pmod_debug.brd from below]

Board: 2 copper layers, 57.1 x 15.2 mm, 89 parts (19 on the bottom side), 38 nets.
