apertus-open-source-cinema/alpha-hardware/(commit log)

2013-06-06 Initial Commit of SFE Files (schematic and PCB layout)
    [cmv12000 adapter.pcb, cmv12000 adapter.sch]
2013-06-11 some progress with GND plane connections and a couple of capacitors routed
    [cmv12000 adapter V002.pcb]
2013-06-12 added axiom alpha nikon lens f-mount mechanical drawings
2013-06-18 more PCB routing progress
    added CMV12000 chip size
    added pcb to lens mount screw holes
    some problems fixed
    board size slightly increased to accomodate screw holes for lens mount
    more capacitors routed
    [cmv12000 adapter V002.pcb, cmv12000 adapter V003.pcb]
2013-06-18 more PCB progress
    some more capacitors placed and routed
    [cmv12000 adapter V003.pcb]
2013-06-18 preliminary CMV12000 KiCad Component (WIP)
2013-06-18 minor board size tweaks - still needs fixing
    [cmv12000 adapter V003.pcb]
2013-06-18 all parts placed and routed
    [cmv12000 adapter V003.pcb, cmv12000 adapter V004.pcb]
2013-06-18 updated todos
    [cmv12000 adapter V004.pcb]
2013-06-21 3.3v supply plane and connections done
    [cmv12000 adapter V005.pcb]
2013-06-21 finished 3.0V and 1.8V power planes, added voltage area overview PSD
    [cmv12000 adapter V005.pcb]
2013-06-22 added power planes jpg
2013-06-24 updates, fixes, improvements
    [cmv12000 adapter V005.pcb, cmv12000 adapter.sch]
2013-06-26 more PCB routing progress
    [cmv12000 adapter V006.pcb, cmv12000 adapter V007.pcb]
2013-06-26 again more PCB updates
    [cmv12000 adapter V007.pcb, cmv12000 adapter V008.pcb, cmv12000 adapter V009.pcb]
2013-07-01 more progress
    [cmv12000 adapter V009.pcb]
2013-07-08 pmod led matrix hardware added
    [pmod_debug.brd, pmod_debug.sch]
2013-07-11 lots of updates
    [cmv12000 adapter V002.pcb, cmv12000 adapter V003.pcb, cmv12000 adapter V004.pcb, cmv12000 adapter V005.pcb, cmv12000 adapter V006.pcb, cmv12000 adapter V007.pcb, cmv12000 adapter V008.pcb, cmv12000 adapter V009.pcb]
2013-07-11 eagle library added (FMC connector and Cmosis CMV12000)
2013-07-12 version 0.8 of the SFE PCB now complete - ready for review/eror checking
    [qad-center-v0.8.brd, qad-center-v0.8.sch]
2013-07-12 added cmv12000 operation mode note
    [qad-center-v0.8.sch]
2013-08-21 Version 0.9 of the PCB board layout
    [cmv12k-adapter-v0.9.brd]
2013-08-24 V1.0 commited
    [cmv12k-adapter-v0.9.brd, cmv12k-adapter-v1.0.brd, cmv12k-adapter-v1.0.sch, qad-center-v0.7.brd, qad-center-v0.7.sch, qad-center-v0.8.brd, qad-center-v0.8.sch]
2013-08-24 folder clean up
    [cmv12000 adapter V002.pcb, cmv12000 adapter V003.pcb, cmv12000 adapter V004.pcb, cmv12000 adapter V005.pcb, cmv12000 adapter V006.pcb, cmv12000 adapter V007.pcb, cmv12000 adapter V008.pcb, cmv12000 adapter V009.pcb]
2013-09-26 some restructuring
    [pmod_debug.brd, pmod_debug.sch]
2013-10-28 updated to version 1.1, added bom, gerber, etc
    [cmv12k-adapter-v0.9.brd, cmv12k-adapter-v1.0.brd, cmv12k-adapter-v1.0.sch, cmv12k-adapter-v1.1.brd, cmv12k-adapter-v1.1.sch]
2013-12-05 moved files into subdirectory based on version
    [cmv12k-adapter-v1.1.brd, cmv12k-adapter-v1.1.sch, cmv12k-adapter-v1.2.brd, cmv12k-adapter-v1.2.sch]
2013-12-05 removed old files now in cmv12k-adapter-v1.1
    [cmv12k-adapter-v1.1.brd, cmv12k-adapter-v1.1.sch]
2014-01-22 updated image sensor datasheet
2014-04-01 1D 4K Paddle Schematic and Board Layout
    [paddle.brd, paddle.sch]
2014-04-01 Added Copyright, License and Frame
    [paddle.brd, paddle.sch]
2014-06-10 3D CAD file of lens mount parts
    [F-mount to CMV12k-V04.stp]
